iliasam/uProbe/Mechanics/mask1_300dpi.png

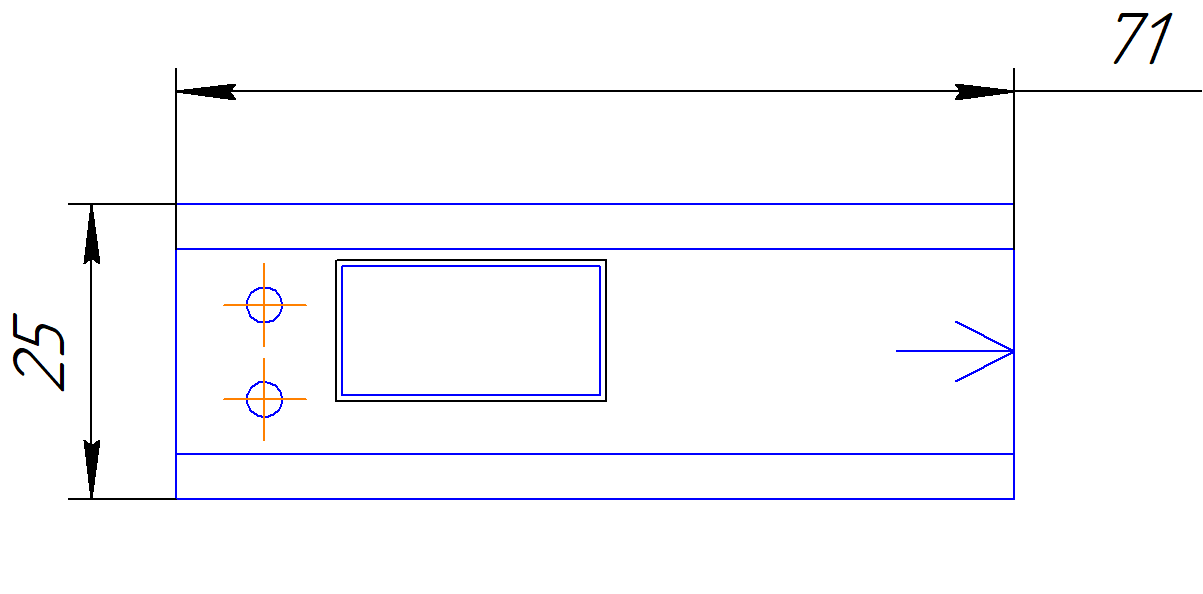
Mechanics/mask1_300dpi.png
