iliasam/uProbe/Schematic/Schematic_v2_0.png

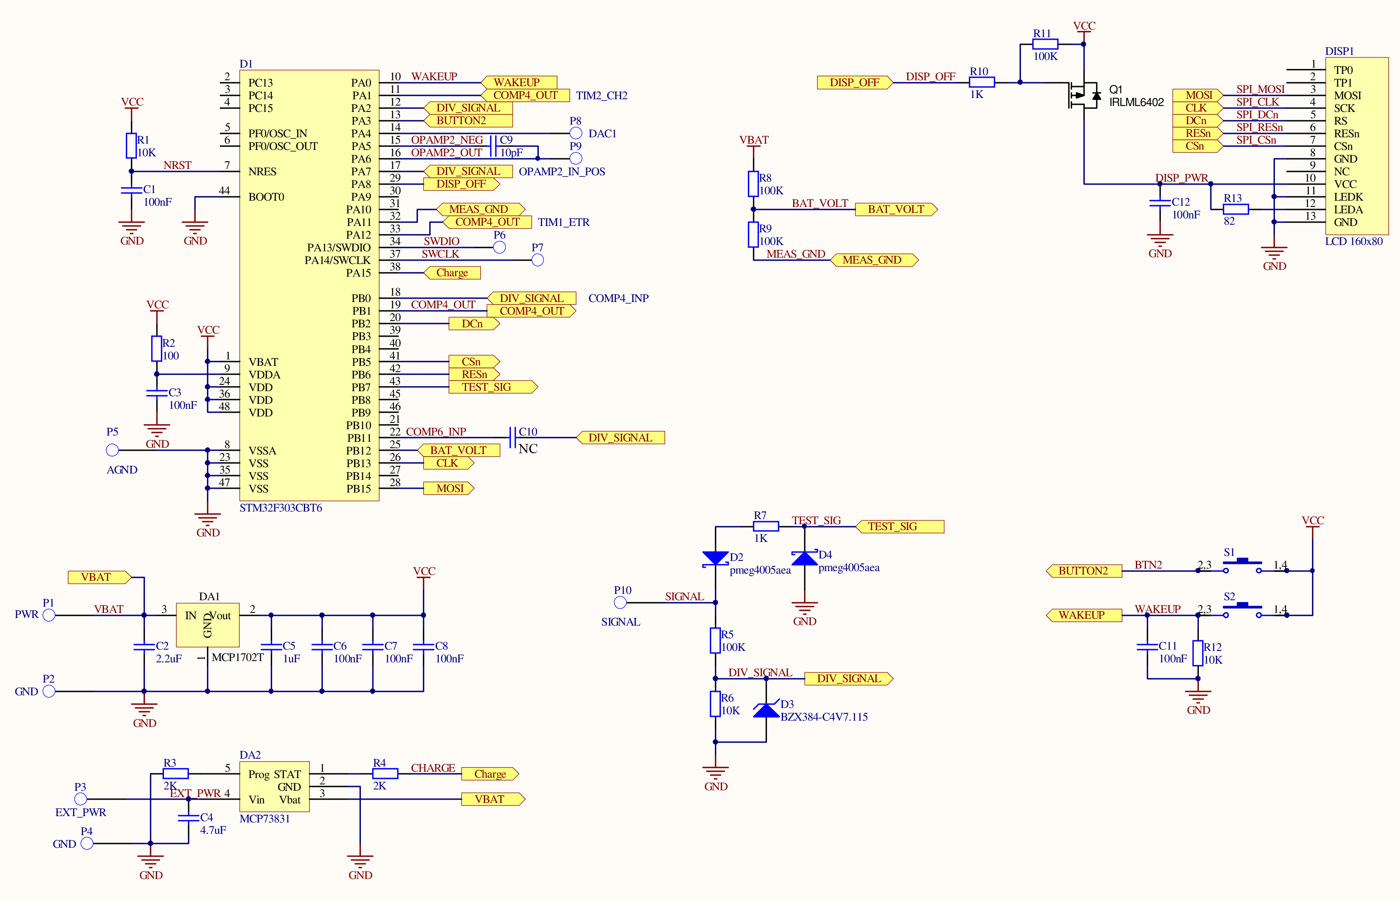
Schematic/Schematic_v2_0.png
