iliasam/uProbe/Schematic/structure.png

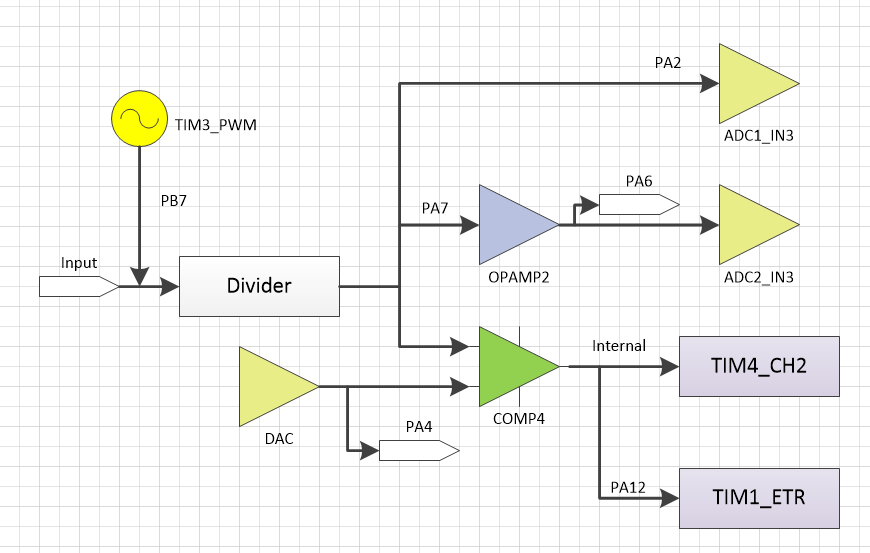
Schematic/structure.png
