iliasam/uProbe/Schematic/BOM_v2_0.xlsx

Designator | Comment | Description | Footprint | Quantity
C1, C3, C6, C7, C8, C11, C12 | 100nF | Chip capacitor | CAPC1608X90N (0603) | 7
C2 | 2.2uF | Chip capacitor | CAPC2012X135N (0805) | 1
C4 | 4.7uF | Chip capacitor | CAPC2012X135N (0805) | 1
C5 | 1uF | Chip capacitor | CAPC2012X135N (0805) | 1
C9 | 10pF | Chip capacitor | CAPC1608X90N (0603) | 1
DD1 | STM32F303CBT6 | Microcontroller | LQFP-48_N | 1
D2, D4 | PMEG4005AEA | Schottky Diode | SOD-323F/SC-90_INV | 2
D3 | BZX384-C4V7.115 | Zener Diode | SOD-323F/SC-90_INV | 1
DA1 | MCP1702T-3302 | Linear voltage regulator 3.3V | SOT23-3 | 1
DA2 | MCP73831T-2ATI/OT | Li-Ion Charger | SOT23-5 | 1
DISP1 | LCD 160x80 | LCD 160x80 | LCD_160_80 | 1
Q1 | IRLML6402 | MOSFET SMD P-CH | SOT23-3 | 1
R1, R6, R12 | 10K | Chip resistor | RESC1608X55N (0603) | 3
R2 | 100 | Chip resistor | RESC1608X55N (0603) | 1
R3, R4 | 2K | Chip resistor | RESC1608X55N (0603) | 2
R5, R8, R9, R11 | 100K | Chip resistor | RESC1608X55N (0603) | 4
R7, R10 | 1K | Chip resistor | RESC1608X55N (0603) | 2
R13 | 82 | Chip resistor | RESC1608X55N (0603) | 1
S1, S2 | SWT-6 | Button - 5.3mm height | BUTTON_B3FS | 2
