iliasam/uProbe/Mechanics/mask1.dxf

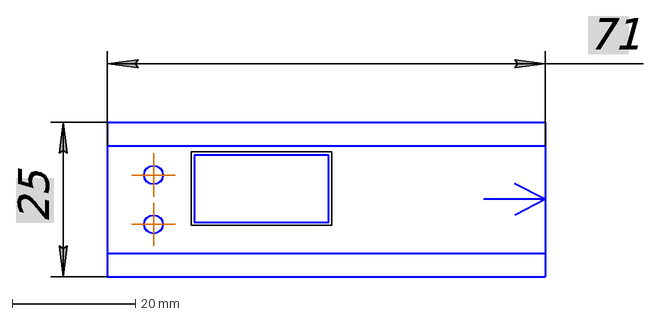
[picture p8: CAD file, 2021-03-06]
Mechanics/mask1.dxf
71
25
