iliasam/uProbe/Schematic/AssemblyBOTTOM.png

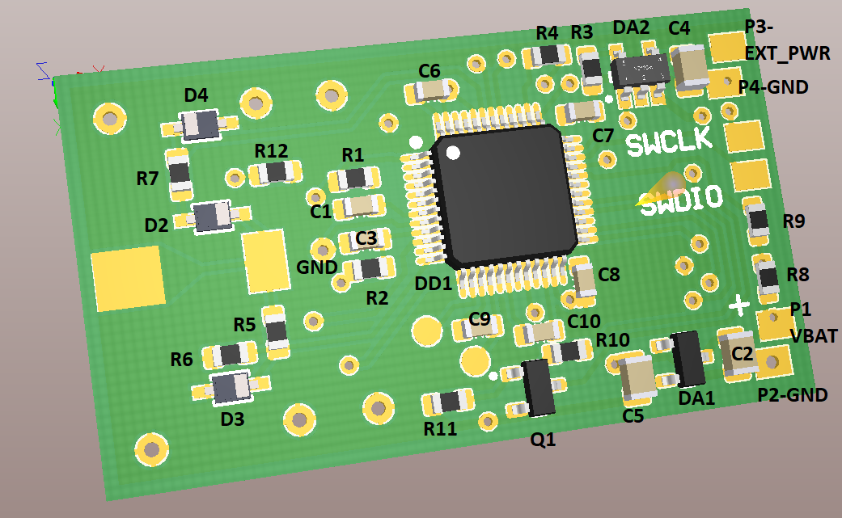
Schematic/AssemblyBOTTOM.png
