iliasam/uProbe/Schematic/AssemblyTOP.png

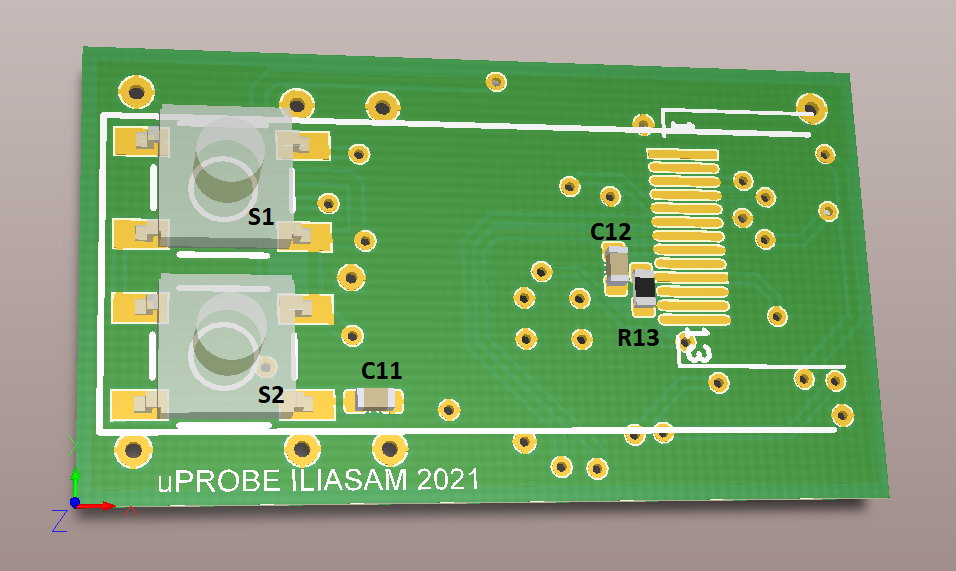
Schematic/AssemblyTOP.png
