iliasam/uProbe/(threads)

Thread 1 (2023-04-29):

Cannot compile

Pep00000001, 2023-04-29:
Im using IAR v7502-10505
loaded the project file project.eww - no changes to code
hit make, got missing file error "startup_stm32f303xc" in system folder
Grabbed the STM32F30x_StdPeriph_Driver from ST and put the file into the project  /system folder now the build log has 182 errors

how to fix ?

iliasam, 2023-04-29:
I added my startup_stm32f303xc.s file to the repository, try to update your sources ftom Git.
#https://github.com/iliasam/uProbe/commit/71181a42fabd19d7c2ea7975eda7543e71634ebe

Pep00000001, 2023-04-29:
That fixed it. Thanks!

Closed 2023-04-29.
