iliasam/uProbe/(list of files, drawings)

Other design files:
Schematic/Project/PCB1.PcbDoc
Schematic/Project/Sheet1.SchDoc
Schematic/Project/uProbe1_1.PrjPcb
Schematic/Project/uProbe2_0.PrjPcb
