iliasam/uProbe/Firmware/test1/mode_controlling.c

//Drawinf off modes are called from here

/* Includes ------------------------------------------------------------------*/
#include "mode_controlling.h"
#include "display_functions.h"
#include "data_processing.h"
#include "comparator_handling.h"
#include "freq_measurement.h"
#include "slow_scope.h"
#include "baud_meter.h"
#include "menu_selector.h"
#include "string.h"
#include "stdio.h"
#include "power_controlling.h"

/* Private typedef -----------------------------------------------------------*/
/* Private define ------------------------------------------------------------*/
#define VOLTAGE_BAR_HEIGHT              (6)

//Horizontal bar levels
#define MENU_LOW_LEVEL_VALUE_V          (1.0f)
#define HOR_BAR_HIGH_LEVEL_VALUE_V      (2.0f)
#define HOR_BAR_MAX_LEVEL_VALUE_V       (5.0f)
/* Private macro -------------------------------------------------------------*/
/* Private variables ---------------------------------------------------------*/
menu_mode_t main_menu_mode = MENU_MODE_LOGIC_PROBE;

freq_meter_calib_state_t freq_meter_calib_state = FREQ_METER_CALIB_IDLE;

uint8_t mode_controling_low_batt_flag = 0;



/* Private function prototypes -----------------------------------------------*/
void menu_draw_logic_probe_menu(menu_draw_type_t draw_type);
void menu_draw_voltmeter_menu(menu_draw_type_t draw_type);
void menu_print_current_frequency(char* str);

void menu_baud_meter_menu(menu_draw_type_t draw_type);
void menu_freq_meter_upper_button_pressed(void);
void draw_not_supported(void);
void menu_draw_voltage_bar(float meas_avr_voltage_v);
uint16_t menu_draw_get_bar_horiz_value_pix(float voltage_v);

/* Private functions ---------------------------------------------------------*/

void menu_main_init(void)
{
  data_processing_main_mode_changed();
  menu_redraw_display(MENU_MODE_FULL_REDRAW);
}

void menu_lower_button_pressed(void)
{
  if (menu_selector_submenu_active())
  {
    menu_selector_lower_button_pressed();
    return;
  }
  
  //Current mode must be checked here
  //and based on it we need to switch to a next menu or execute command
  menu_main_switch_to_next_mode();
}

void menu_lower_button_hold(void)
{
  switch (main_menu_mode)
  {
    case MENU_SELECTOR:
      menu_selector_lower_button_hold();
      break;
    
    default: break;
  }
}

void menu_upper_button_pressed(void)
{
  switch (main_menu_mode)
  {
    case MENU_MODE_FREQUENCY_METER:
      menu_freq_meter_upper_button_pressed();// Handler is in this file
      break;
    
    case MENU_MODE_SLOW_SCOPE:
      slow_scope_upper_button_pressed();
      break;
    
    case MENU_SELECTOR:
      menu_selector_upper_button_pressed();
      break;
    
    default: break;
  }
}

void menu_upper_button_hold(void)
{
  switch (main_menu_mode)
  {
    case MENU_SELECTOR:
      menu_selector_upper_button_hold();
      break;
    
    default: break;
  }
}

// Switch main menu mode to a next mode
void menu_main_switch_to_next_mode(void)
{
  main_menu_mode++;
  if (main_menu_mode >= MENU_MODE_COUNT)
    main_menu_mode = (menu_mode_t)0;
  
  data_processing_main_mode_changed();
  menu_redraw_display(MENU_MODE_FULL_REDRAW);
}

//Redraw display depending on menu mode
void menu_redraw_display(menu_draw_type_t draw_type)
{
  switch (main_menu_mode)
  {
    case MENU_MODE_LOGIC_PROBE:
      menu_draw_logic_probe_menu(draw_type);
    break;
    
    case MENU_MODE_VOLTMETER:
      menu_draw_voltmeter_menu(draw_type);
    break;
    
    case MENU_MODE_FREQUENCY_METER:
      menu_draw_frequency_meter_menu(draw_type);
    break;
    
    case MENU_MODE_BAUD_METER:
      menu_baud_meter_menu(draw_type);
    break;
    
    case MENU_MODE_SLOW_SCOPE:
      slow_scope_draw_menu(draw_type);
    break;
    
    case MENU_SELECTOR:
      menu_selector_draw(draw_type);
    break;
    
    
    default: 
      draw_not_supported();
      break;
  }
}

void menu_redraw_caption(menu_draw_type_t draw_type)
{
  if (power_controlling_is_batt_low())
  {
    display_draw_string("**BATTERY LOW!**", 30, 0, FONT_SIZE_8, LCD_INVERTED_FLAG, COLOR_YELLOW);
    mode_controling_low_batt_flag = 1;
    return;
  }
  else
  {
    if (mode_controling_low_batt_flag)
    {
      //clear LOW BATT message
      mode_controling_low_batt_flag = 0;
      display_draw_string("                ", 30, 0, FONT_SIZE_8, 0, COLOR_YELLOW);
    }
  }
  
  switch (main_menu_mode)
  {
    case MENU_MODE_LOGIC_PROBE:
      display_draw_string("LOGIC PROBE MODE", 30, 0, FONT_SIZE_8, 0, COLOR_YELLOW);
    break;
    
    case MENU_MODE_VOLTMETER:
      display_draw_string("VOLTMETER MODE", 40, 0, FONT_SIZE_8, 0, COLOR_YELLOW);
    break;
    
    case MENU_MODE_FREQUENCY_METER:
      display_draw_string("FREQUENCY MEASUREMENT", 20, 0, FONT_SIZE_8, 0, COLOR_YELLOW);
    break;
    
    case MENU_MODE_BAUD_METER:
      display_draw_string("BAUDRATE MEASUREMENT", 20, 0, FONT_SIZE_8, 0, COLOR_YELLOW);
    break;
    
    case MENU_MODE_SLOW_SCOPE:
      slow_scope_draw_caption();
    break;

    default:
      break;
  }
}

void draw_not_supported(void)
{
  display_clear_framebuffer();
  display_draw_string("NOT SUPPORTED", 0, 0, FONT_SIZE_11, 0, COLOR_WHITE);
  display_update();
}


void menu_draw_logic_probe_menu(menu_draw_type_t draw_type)
{
  if (draw_type == MENU_MODE_FULL_REDRAW)
  {
    display_clear_framebuffer();
    menu_redraw_caption(draw_type);
    display_update();
  }
  else //PARTIAL update
  {
    if (data_processing_state == PROCESSING_DATA_DONE)
    {
      data_processing_start_new_capture();
      return;
    }
    
    char tmp_str[32];
    if (data_processing_state != PROCESSING_IDLE)
    {
      menu_redraw_caption(draw_type);
      
      switch (logic_probe_signal_state)
      {
      case SIGNAL_TYPE_Z_STATE:
        display_draw_string("Z STATE", 0, 17, FONT_SIZE_33, 0, COLOR_WHITE);
        break;
      case SIGNAL_TYPE_LOW_STATE:
        display_draw_string("  LOW  ", 0, 17, FONT_SIZE_33, 0, COLOR_WHITE);
        break;
      case SIGNAL_TYPE_HIGH_STATE:
        display_draw_string("  HIGH ", 0, 17, FONT_SIZE_33, 0, COLOR_WHITE);
        break;
      case SIGNAL_TYPE_PULSED_STATE:
        display_draw_string(" PULSE ", 0, 17, FONT_SIZE_33, 0, COLOR_WHITE);
        break;
      case SIGNAL_TYPE_UNKNOWN_STATE:
        display_draw_string("UNKNOWN", 0, 17, FONT_SIZE_33, 0, COLOR_WHITE);
        break;
      default: break;
      }
      
      //Draw voltage when input voltage is stable
      if ((logic_probe_signal_state == SIGNAL_TYPE_LOW_STATE) || 
          (logic_probe_signal_state == SIGNAL_TYPE_HIGH_STATE) ||
          (logic_probe_signal_state == SIGNAL_TYPE_UNKNOWN_STATE))
      {
        menu_print_big_voltage(tmp_str, voltmeter_voltage);
        display_draw_string(tmp_str, 55, 63, FONT_SIZE_11, 0, COLOR_WHITE);
      }
      else
      {
        display_draw_string("        ", 55, 63, FONT_SIZE_11, 0, COLOR_WHITE);
      }
      
      menu_draw_voltage_bar(voltmeter_voltage);

      display_update();
    }
  }
}

void menu_draw_voltage_bar(float meas_avr_voltage_v)
{
  uint16_t start_y = 51;
  
  uint16_t low_x_offset_pix = 
    menu_draw_get_bar_horiz_value_pix(MENU_LOW_LEVEL_VALUE_V);
  uint16_t hight_x_offset_pix = 
    menu_draw_get_bar_horiz_value_pix(HOR_BAR_HIGH_LEVEL_VALUE_V);
  
  
  uint8_t color = 0;
  for (uint16_t x = 0; x < LCD_RIGHT_OFFSET; x++)
  {
    if (x < low_x_offset_pix)
      color = COLOR_BLUE;
    else if (x < hight_x_offset_pix)
      color = COLOR_YELLOW;
    else
      color = COLOR_RED;
    
    if ((x % 2) != 0)
      color = COLOR_GRAY;
    
    float horiz_volatge = (float)x * HOR_BAR_MAX_LEVEL_VALUE_V / (float)LCD_RIGHT_OFFSET;
    if (horiz_volatge > meas_avr_voltage_v)
      color = COLOR_BLACK;
      
    display_draw_vertical_line(
        x, start_y, start_y + VOLTAGE_BAR_HEIGHT, color);//low
  }
  
  display_draw_vertical_line(
    low_x_offset_pix, start_y, start_y + VOLTAGE_BAR_HEIGHT, COLOR_WHITE);//low
  
  display_draw_vertical_line(
    hight_x_offset_pix, start_y, start_y + VOLTAGE_BAR_HEIGHT, COLOR_WHITE);//low
  
  display_draw_line(start_y, COLOR_WHITE);//upper line
  display_draw_line(start_y + VOLTAGE_BAR_HEIGHT, COLOR_WHITE);//lower line
  display_draw_vertical_line(
    0, start_y, start_y + VOLTAGE_BAR_HEIGHT, COLOR_WHITE);//left
  display_draw_vertical_line(
    LCD_RIGHT_OFFSET, start_y, start_y + VOLTAGE_BAR_HEIGHT, COLOR_WHITE);//right
  
  display_draw_string("0", 
    0, start_y + VOLTAGE_BAR_HEIGHT + 3, FONT_SIZE_8, 0, COLOR_WHITE);
  
  char tmp_str[5];
  sprintf(tmp_str, " %d ", (uint16_t)HOR_BAR_MAX_LEVEL_VALUE_V);
  display_draw_string(tmp_str,
    LCD_RIGHT_OFFSET - 12, start_y + VOLTAGE_BAR_HEIGHT + 3, FONT_SIZE_8, 0, COLOR_WHITE);
}

//Return value in horiz pixels
uint16_t menu_draw_get_bar_horiz_value_pix(float voltage_v)
{
  float result = voltage_v * (float)LCD_RIGHT_OFFSET / HOR_BAR_MAX_LEVEL_VALUE_V;
  return (uint16_t)result;
}

//*****************************************************************************
void menu_draw_voltmeter_menu(menu_draw_type_t draw_type)
{
  if (draw_type == MENU_MODE_FULL_REDRAW)
  {
    display_clear_framebuffer();
    menu_redraw_caption(draw_type);
    display_update();
  }
  else //PARTIAL update
  {
    if (data_processing_state == PROCESSING_DATA_DONE)
    {
      data_processing_start_new_capture();
      return;
    }
    
    if (data_processing_state != PROCESSING_IDLE)
    {
      menu_redraw_caption(draw_type);
      char tmp_str[32];
      menu_print_big_voltage(tmp_str, voltmeter_voltage);
      if (voltmeter_voltage < 28)
        display_draw_string(tmp_str, 20, 20, FONT_SIZE_33, 0, COLOR_WHITE);
      else
        display_draw_string(tmp_str, 20, 20, FONT_SIZE_33, 0, COLOR_RED);//Inaccurate
      display_update();
    }
    
    //voltmeter_voltage
    
  }
}

//*****************************************************************************
void menu_draw_frequency_meter_menu(menu_draw_type_t draw_type)
{
  if (draw_type == MENU_MODE_FULL_REDRAW)
  {
    display_clear_framebuffer();
    menu_redraw_caption(draw_type);
    
    if (freq_meter_calib_state == FREQ_METER_CALIB_WAIT_START)
    {   
      display_draw_string("  AUTO TRIGGER ", 0, 15, FONT_SIZE_11, 0, COLOR_WHITE);
      display_draw_string(" TOUCH TO SIGNAL", 0, 29, FONT_SIZE_11, 0, COLOR_WHITE);
    }
    else if (freq_meter_calib_state == FREQ_METER_CALIB_CAPTURE)
    {
      display_draw_string("  AUTO TRIGGER ", 0, 15, FONT_SIZE_11, 0, COLOR_WHITE);
      display_draw_string("   HOLD PROBE", 0, 29, FONT_SIZE_11, 0, COLOR_WHITE);
    }
    else if (freq_meter_calib_state == FREQ_METER_CALIB_DONE)
    {
      char tmp_str[32];
      sprintf(tmp_str, " MIN voltage: %.02fV", comparator_min_voltage);
      display_draw_string(tmp_str, 0, 22, FONT_SIZE_11, 0, COLOR_WHITE);
      sprintf(tmp_str, " MAX voltage: %.02fV", comparator_max_voltage);
      display_draw_string(tmp_str, 0, 35, FONT_SIZE_11, 0, COLOR_WHITE);
      sprintf(tmp_str, " TRIGGER: %.02fV", comparator_threshold_v);
      display_draw_string(tmp_str, 0, 48, FONT_SIZE_11, 0, COLOR_WHITE);
    }
    else
    {
      display_draw_string("UNKNOWN", 0, 20, FONT_SIZE_33, 0, COLOR_WHITE);
    }
    
    display_update();
  }
  else //PARTIAL update
  {
    if (freq_measurement_state == FREQ_MEASUREMENT_PROCESSING_DATA_DONE)
    {
      menu_redraw_caption(draw_type);
      char tmp_str[32];
      if (freq_meter_calib_state == FREQ_METER_CALIB_IDLE)//normal working
      {
        menu_print_current_frequency(tmp_str);
        display_draw_string(tmp_str, 0, 20, FONT_SIZE_33, 0, COLOR_WHITE);
        
        sprintf(tmp_str, "LEVEL: %.02f V", freq_comparator_threshold_v);
        display_draw_string(tmp_str, 30, 65, FONT_SIZE_11, 0, COLOR_WHITE);
        
        display_update();
        
        freq_measurement_start_freq_capture();
      }
    }
  }
}

void menu_freq_meter_upper_button_pressed(void)
{
  if (freq_meter_calib_state == FREQ_METER_CALIB_IDLE)
  {
    freq_meter_calib_state = FREQ_METER_CALIB_WAIT_START;// Wait for calibration start
    menu_draw_frequency_meter_menu(MENU_MODE_FULL_REDRAW);
  }
}

//*****************************************************************************

void menu_baud_meter_menu(menu_draw_type_t draw_type)
{
  if (draw_type == MENU_MODE_FULL_REDRAW)
  {
    display_clear_framebuffer();
    menu_redraw_caption(draw_type);
    display_update();
  }
  else //PARTIAL update
  {
    menu_redraw_caption(draw_type);
    char tmp_str[32];
    if (baud_meter_current_rounded_baud < 100)
      sprintf(tmp_str, "  NONE  ");
    else
      sprintf(tmp_str, "%d    ", baud_meter_current_rounded_baud);
    
    display_draw_string(tmp_str, 0, 20, FONT_SIZE_33, 0, COLOR_WHITE);
    display_update();
  }
}
//*****************************************************************************

void menu_print_current_frequency(char* str)
{
  if (freq_measurement_calc_frequency < 9)
    sprintf(str, "UNKNOWN");
  else if (freq_measurement_calc_frequency > 99999)//100khz
    sprintf(str, "%d KHz", (freq_measurement_calc_frequency / 1000));
  else if (freq_measurement_calc_frequency > 9999)//10 khz
  {
    float freq_khz = (float)freq_measurement_calc_frequency / 1000;//in kHz
    sprintf(str, "%.02f K", freq_khz);
  }
  else if (freq_measurement_calc_frequency < 1000)//1 khz
    sprintf(str, " %d Hz    ", freq_measurement_calc_frequency);
  else
    sprintf(str, "%dHz    ", freq_measurement_calc_frequency);
}

void menu_print_big_voltage(char* str, float voltage)
{
  if (voltage <= 9.9f)
    sprintf(str, " %.01fV ", voltage);
  else
    sprintf(str, "%.01fV ", voltage);
}

// Shift null-terminated string to right corner
// max_size - max size of the string
void menu_shift_string_right(char* str, uint8_t max_size)
{
  uint8_t data_size = strlen(str);//length of data in string
  
  if (data_size > max_size)
    return; //nothing to shift
  
  for (uint8_t i = 0; i < data_size; i++)
  {
    str[max_size - i - 1] = str[data_size - i - 1];
  }
  
  //Replace first symbols by spaces
  memset(str, ' ', (max_size - data_size));
}
