iliasam/uProbe/Firmware/test1/hardware.h

/* Define to prevent recursive inclusion -------------------------------------*/
#ifndef __HARDWARE_H
#define __HARDWARE_H

/* Includes ------------------------------------------------------------------*/
#include "stm32f30x.h"
#include "config.h"

/* Exported types ------------------------------------------------------------*/
/* Exported constants --------------------------------------------------------*/
/* Exported macro ------------------------------------------------------------*/
/* Exported functions ------------------------------------------------------- */
void hardware_init_all(void);
void dwt_delay_us(uint32_t us);

uint32_t hardware_dwt_get(void);

#endif /* __HARDWARE_H */
