iliasam/uProbe/Firmware/test1/SignalCapture/adc_controlling.h

#ifndef __ADC_CONTROLLING_H
#define __ADC_CONTROLLING_H

// Number of simultaneously captured points
#define MAIN_ADC_CAPTURED_POINTS        1000

#define MAIN_ADC_MAX_VALUE              4095
#define MAIN_ADC_HALF_VALUE             ((MAIN_ADC_MAX_VALUE + 1) / 2)

//Two ADC's are workng simultaneously
//Size in uint16_t elements
#define ADC_BUFFER_SIZE (uint16_t)(MAIN_ADC_CAPTURED_POINTS * 2)

typedef enum
{
  NO_CAPTURE = 0,
  CAPTURE_IN_PROCESS,
  CAPTURE_DONE
} cap_status_type;//image capture status

extern uint32_t adc_current_sample_rate;

void adc_init_all(void);

void adc_capture_start(void);
void capture_dma_stop(void);

void adc_start_trigger_timer(void);
void init_capture_gpio(void);
void adc_set_sample_rate(uint32_t frequency);


void set_adc_buf(void);

#endif 
