iliasam/uProbe/Firmware/test1/hardware.c

/* Includes ------------------------------------------------------------------*/
#include "hardware.h"

/* Private typedef -----------------------------------------------------------*/
/* Private define ------------------------------------------------------------*/
/* Private macro -------------------------------------------------------------*/
/* Private variables ---------------------------------------------------------*/
/* Private function prototypes -----------------------------------------------*/
void hardware_init_rcc(void);
void hardware_opamp_init(void);

void hardware_dwt_init(void);
uint32_t hardware_dwt_get(void);
uint8_t hardware_dwt_comapre(int32_t tp);


/* Private functions ---------------------------------------------------------*/

void hardware_init_all(void)
{
  NVIC_PriorityGroupConfig(NVIC_PriorityGroup_0);
  
  hardware_init_rcc();
  
  RCC_ClocksTypeDef RCC_Clocks;
  RCC_GetClocksFreq (&RCC_Clocks);
  SysTick_Config(RCC_Clocks.HCLK_Frequency / 1000);
  
  hardware_dwt_init();
  hardware_opamp_init();
}

//Initialize main clock system
void hardware_init_rcc(void)
{
  //switch to HSI
  RCC_SYSCLKConfig(RCC_SYSCLKSource_HSI);
  while (RCC_GetSYSCLKSource() != 0x00) {}
  RCC_DeInit();

  // PLL config 8 MHz / 2 * 8 = 32 MHz
  RCC_PLLConfig(RCC_PLLSource_HSI_Div2, RCC_PLLMul_8); 
  RCC_PLLCmd(ENABLE);
  while (RCC_GetFlagStatus(RCC_FLAG_PLLRDY) == RESET) {}
  RCC_SYSCLKConfig(RCC_SYSCLKSource_PLLCLK);
  while (RCC_GetSYSCLKSource() != 0x08) {}
  SystemCoreClockUpdate();
}

//Init DWT counter
void hardware_dwt_init(void)
{
    CoreDebug->DEMCR |= CoreDebug_DEMCR_TRCENA_Msk;
    DWT->CYCCNT = 0;
    DWT->CTRL |= DWT_CTRL_CYCCNTENA_Msk;
}

//OPAMP2 for ADC2
void hardware_opamp_init(void)
{
  OPAMP_InitTypeDef       OPAMP_InitStructure;
  GPIO_InitTypeDef GPIO_InitStructure;
  
  RCC_APB2PeriphClockCmd(RCC_APB2Periph_SYSCFG, ENABLE);
  
  GPIO_StructInit(&GPIO_InitStructure);
  GPIO_InitStructure.GPIO_Mode = GPIO_Mode_AN;
  GPIO_InitStructure.GPIO_Pin = ADC_OPAMP_POS_PIN;
  GPIO_InitStructure.GPIO_PuPd = GPIO_PuPd_NOPULL;
  GPIO_Init(ADC_OPAMP_POS_GPIO, &GPIO_InitStructure);
  
  GPIO_InitStructure.GPIO_Pin = COMP_PIN;
  GPIO_Init(COMP_GPIO, &GPIO_InitStructure);
  
  OPAMP_DeInit(ADC_OPAMP_NAME);
  OPAMP_InitStructure.OPAMP_NonInvertingInput = ADC_OPAMP_POS_INPUT;
  OPAMP_InitStructure.OPAMP_InvertingInput =  OPAMP_InvertingInput_PGA;
  OPAMP_Init(ADC_OPAMP_NAME, &OPAMP_InitStructure);

  OPAMP_PGAConfig(ADC_OPAMP_NAME, ADC_OPAMP_GAIN, OPAMP_PGAConnect_No);

  OPAMP_Cmd(ADC_OPAMP_NAME, ENABLE);
}

// ***************************************************************************

uint32_t hardware_dwt_get(void)
{
  return DWT->CYCCNT;
}

inline uint8_t hardware_dwt_comapre(int32_t tp)
{
  return (((int32_t)hardware_dwt_get() - tp) < 0);
}

// Delay for "us"
void dwt_delay_us(uint32_t us)
{
  int32_t tp = hardware_dwt_get() + us * (SystemCoreClock / 1000000);
  while (hardware_dwt_comapre(tp));
}
