iliasam/uProbe/Firmware/test1/Display/display_functions.h

#ifndef __DISPLAY_FUNCTIONS_H
#define __DISPLAY_FUNCTIONS_H

#include "stdint.h"
#include "string.h"
#include "ST7735.h"
#include "fonts.h"

#define DISPLAY_WIDTH           DISP_WIDTH
#define DISPLAY_HEIGHT          DISP_HEIGHT

#define LCD_LEFT_OFFSET         0
#define LCD_RIGHT_OFFSET        (DISPLAY_WIDTH - 1)//max value that is allowed

#define FONT_SIZE_6             6//3*5
#define FONT_SIZE_6_WIDTH       4//3*5

#define FONT_SIZE_8             8//5*7
#define FONT_SIZE_8_WIDTH       6//5*7

#define FONT_SIZE_11            12//7*11
#define FONT_SIZE_11_WIDTH      8//7*11

#define FONT_SIZE_22            22
#define FONT_SIZE_22_WIDTH      16

#define FONT_SIZE_33            33
#define FONT_SIZE_33_WIDTH      23

#define LCD_NEW_LINE_FLAG       1//jump to new line
#define LCD_INVERTED_FLAG       2//inverted draw

void display_full_clear(void);
void display_clear_framebuffer(void);
void display_update(void);
void display_set_pixel_color(uint16_t x, uint16_t y, uint8_t color);

void display_draw_char(uint8_t chr, uint16_t x, uint16_t y, uint8_t font_size, uint8_t flags, uint8_t color);
void display_set_cursor_pos(uint16_t x, uint16_t y);
uint16_t display_draw_string(char *s, uint16_t x, uint16_t y, uint8_t font_size, uint8_t flags, uint8_t color);
uint16_t display_draw_string_cur(char *s, uint8_t font_size, uint8_t flags, uint8_t color);
uint16_t get_font_width(uint8_t font);
void draw_caption_bar(uint8_t height, uint8_t color);

void display_draw_line(uint16_t y, uint8_t color);
void display_draw_vertical_line(uint16_t x, uint16_t y1, uint16_t y2, uint8_t color);

#endif
