iliasam/uProbe/(commit log)

2018-10-27 Added adc, clk init, DWT.
2018-10-27 Added generator timer.
2018-11-07 Added partical power controlling. Working sleep mode.
2018-12-07 Добален опрос кнопок, переключение главных меню. Добавлен режим логическго анализатора. Добавлен шрифт 22x16.
2018-12-08 Added "Voltmeter" mode.
2018-12-08 Added SPI communication with display.
2018-12-09 Added voltage veasurement in "logic probe" mode.
2019-03-10 Добавлены файлы схемы.
    [BOM_v1_1.xls, PCB1.PcbDoc, Sheet1.SchDoc, uProbe1_1.PrjPcb]
2019-03-10 Перенес исходники.
2021-01-16 Changed ADC timer to TIM8
2021-02-27 Project files changed.
    [BOM_v1_1.xls, BOM_v2_0.xls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]
2021-02-27 Added Asembly images.
    [BOM_v2_0.xls, BOM_v2_0.xlsx, PCB1.PcbDoc, Sheet1.SchDoc]
2021-03-06 Added more information for assembling.
    [mask1.dxf]
2021-03-27 Removed measuring baudrate by ADC - now comparator + DWT is used.
2021-06-19 Changed BOM
    [BOM_v2_0.xlsx]
2021-08-28 Updated schematic.
    [BOM_v2_0.xlsx, Sheet1.SchDoc]
2022-05-18 Added displaying voltages under horizontal bar.
2022-09-11 Changed dispalyed version. Published v1.4.
    [BOM_v2_0.xlsx]
